AlexGyver/GRIx4_by_KARMAN/Photo/Model_bot.png

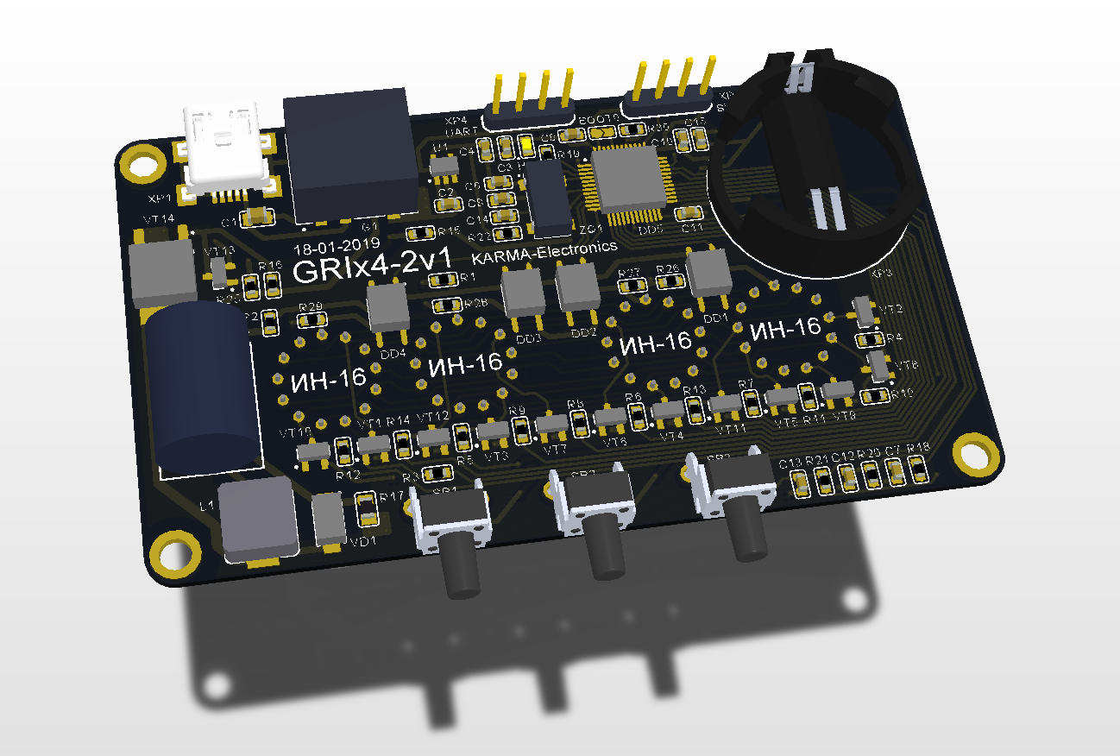
Photo/Model_bot.png
