AlexGyver/GRIx4_by_KARMAN/Photo/PCB2.jpg

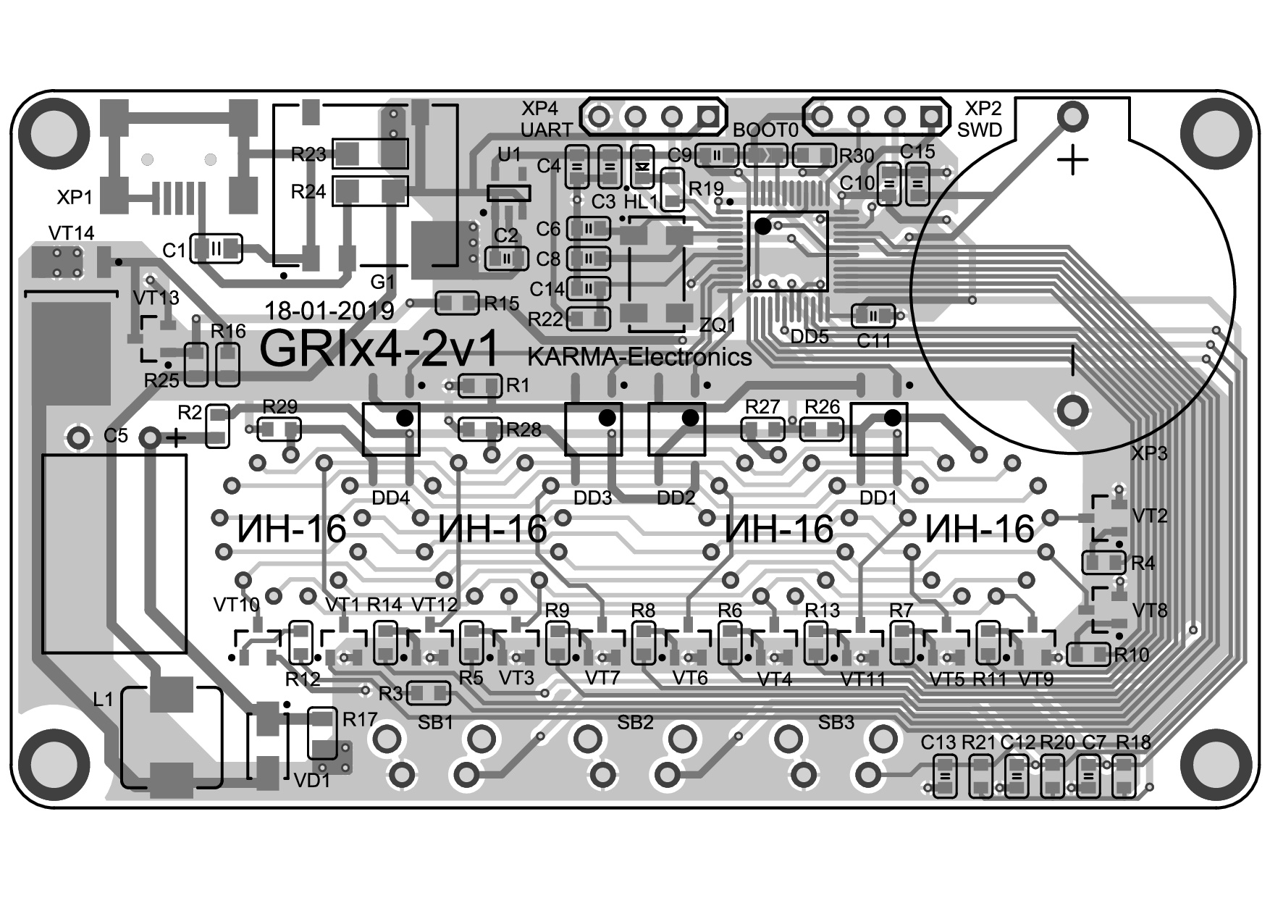
Photo/PCB2.jpg
