AlexGyver/GRIx4_by_KARMAN/Photo/PCB3.jpg

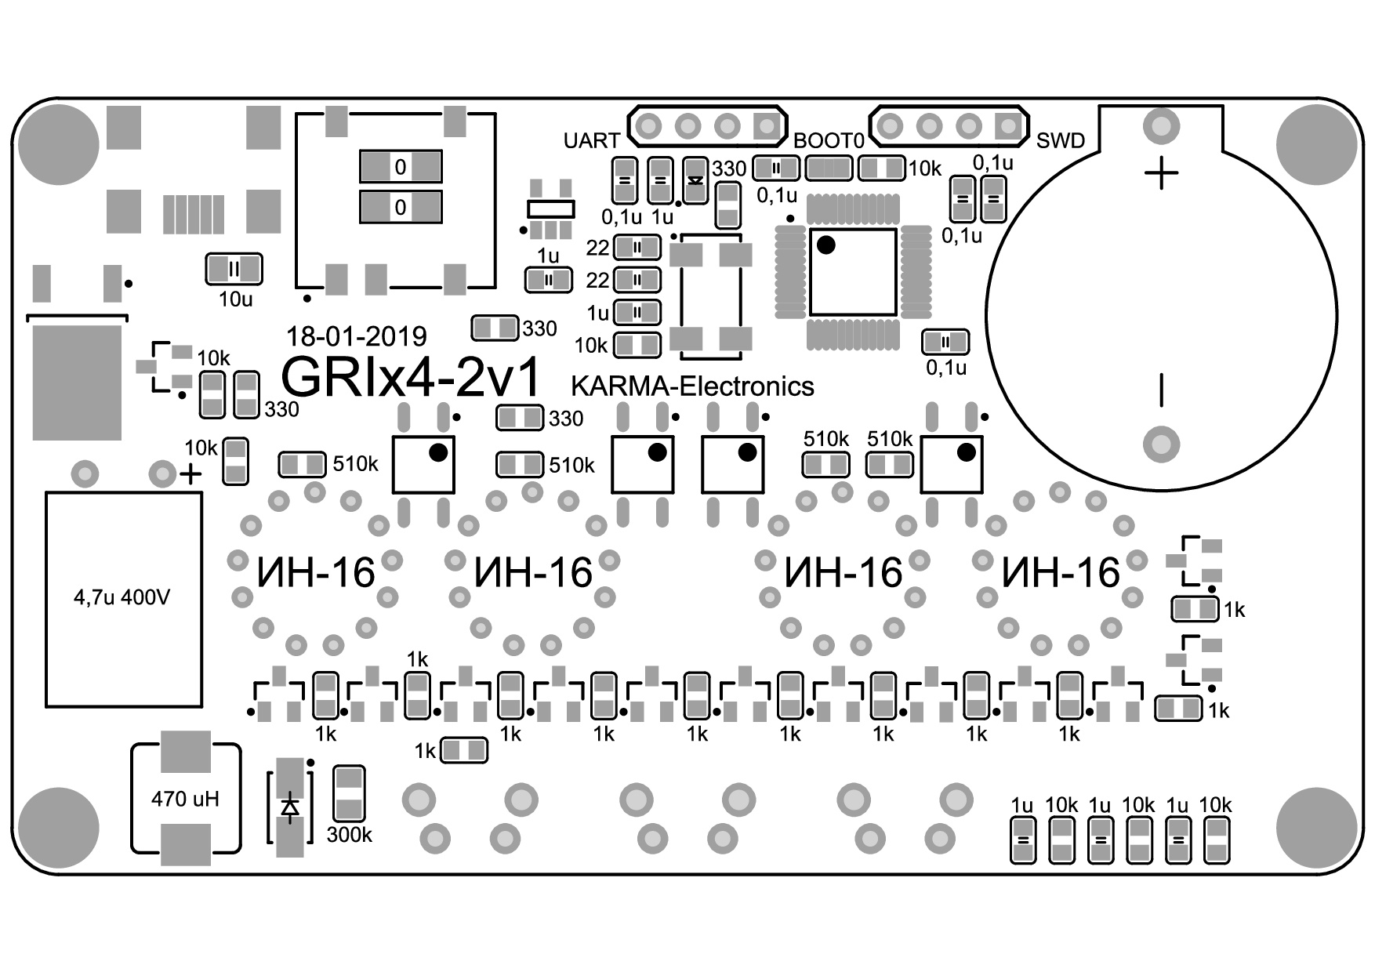
Photo/PCB3.jpg
