AlexGyver/GRIx4_by_KARMAN/Photo/Photo1.jpg

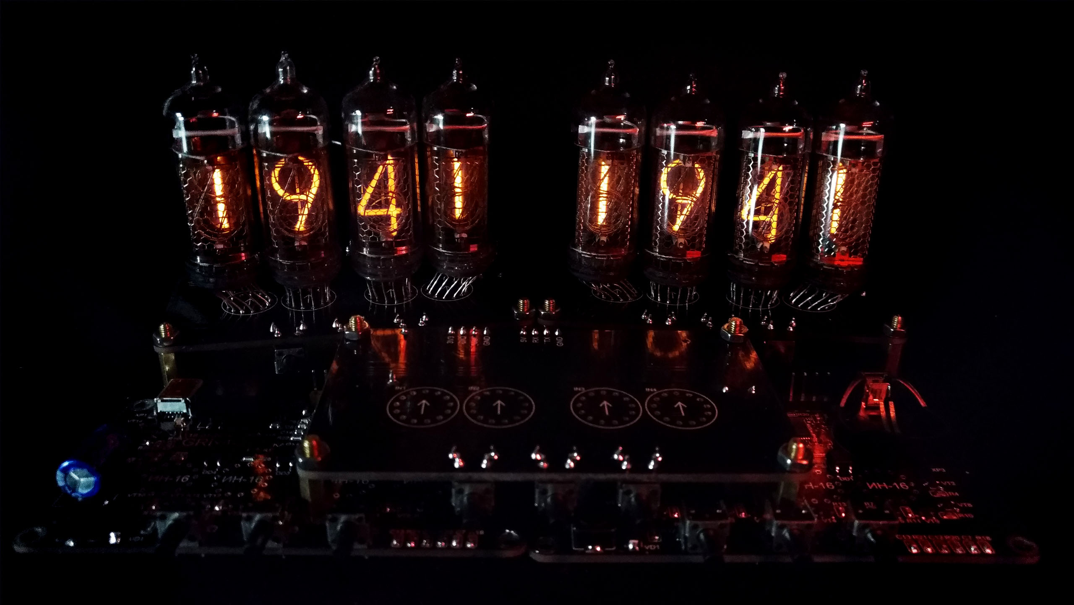
Photo/Photo1.jpg
