AlexGyver/GRIx4_by_KARMAN/Photo/Photo2.jpg

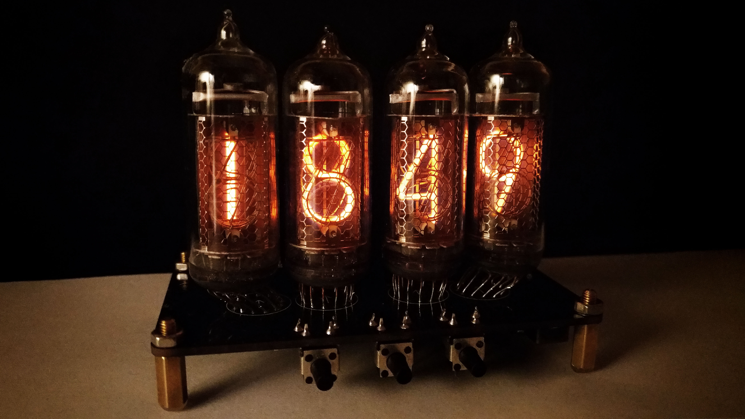
Photo/Photo2.jpg
