AlexGyver/GRIx4_by_KARMAN/Photo/Photo3.jpg

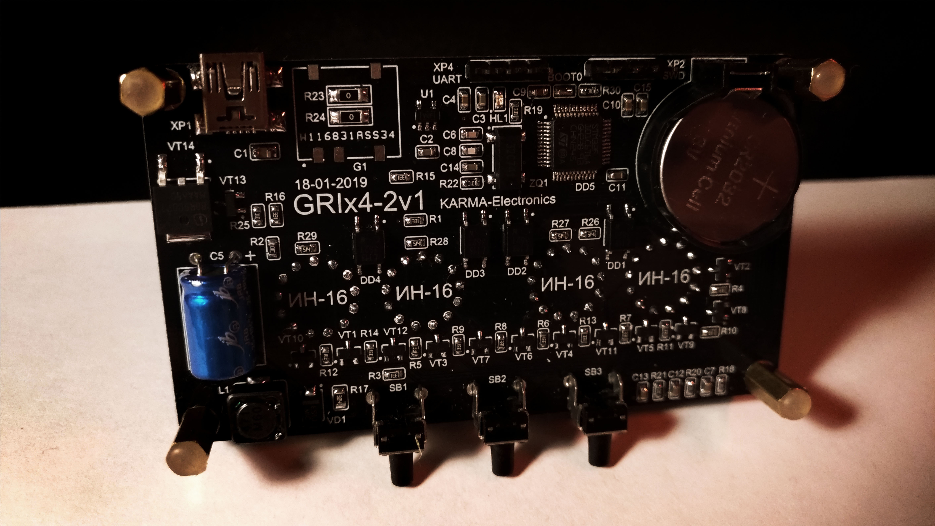
Photo/Photo3.jpg
