AlexGyver/GRIx4_by_KARMAN/(list of files, drawings)

Other design files:
Public/Проект [altium]/GRIx4.PrjPcb
Public/Проект [altium]/GRIx4.SchDoc
