AlexGyver/GRIx4_by_KARMAN/Public/Прошивка [sw4stm32]/Project/GRI.ioc

Mcu.UserName=STM32F101C6Tx
PA0-WKUP.Signal=GPIO_Output
PA1.Signal=GPIO_Output
PA11.Signal=GPIO_Output
PA12.Signal=GPIO_Output
PA13.Signal=SYS_JTMS-SWDIO
PA14.Signal=SYS_JTCK-SWCLK
PA2.Signal=GPIO_Output
PA3.Signal=GPIO_Output
PA4.Signal=GPIO_Output
PA5.Signal=GPIO_Output
PA6.Signal=GPIO_Output
PA7.Signal=GPIO_Input
PA8.Signal=GPIO_Output
PB0.Signal=GPIO_Input
PB1.Signal=GPIO_Input
PB10.Signal=GPIO_Output
PB11.Signal=GPIO_Output
PB12.Signal=GPIO_Output
PB13.Signal=GPIO_Output
PB14.Signal=GPIO_Output
PB15.Signal=GPIO_Output
PB4.Signal=S_TIM3_CH1
PC13-TAMPER-RTC.Signal=GPIO_Output
PC14-OSC32_IN.Signal=RCC_OSC32_IN
PC15-OSC32_OUT.Signal=RCC_OSC32_OUT
