AlexGyver/GRIx4_by_KARMAN/Public/Прошивка [sw4stm32]/Project/Drivers/GRI/GRI.h

#include "stm32f1xx_hal.h"

// Определение деректив переключения катодов
#define C1_set		HAL_GPIO_WritePin(GPIOA, GPIO_PIN_11, GPIO_PIN_SET)
#define C1_res		HAL_GPIO_WritePin(GPIOA, GPIO_PIN_11, GPIO_PIN_RESET)
#define C2_set		HAL_GPIO_WritePin(GPIOB, GPIO_PIN_14, GPIO_PIN_SET)
#define C2_res		HAL_GPIO_WritePin(GPIOB, GPIO_PIN_14, GPIO_PIN_RESET)
#define C3_set		HAL_GPIO_WritePin(GPIOA, GPIO_PIN_4, GPIO_PIN_SET)
#define C3_res		HAL_GPIO_WritePin(GPIOA, GPIO_PIN_4, GPIO_PIN_RESET)
#define C4_set		HAL_GPIO_WritePin(GPIOA, GPIO_PIN_5, GPIO_PIN_SET)
#define C4_res		HAL_GPIO_WritePin(GPIOA, GPIO_PIN_5, GPIO_PIN_RESET)
#define C5_set		HAL_GPIO_WritePin(GPIOB, GPIO_PIN_15, GPIO_PIN_SET)
#define C5_res		HAL_GPIO_WritePin(GPIOB, GPIO_PIN_15, GPIO_PIN_RESET)
#define C6_set		HAL_GPIO_WritePin(GPIOA, GPIO_PIN_6, GPIO_PIN_SET)
#define C6_res		HAL_GPIO_WritePin(GPIOA, GPIO_PIN_6, GPIO_PIN_RESET)
#define C7_set		HAL_GPIO_WritePin(GPIOB, GPIO_PIN_12, GPIO_PIN_SET)
#define C7_res		HAL_GPIO_WritePin(GPIOB, GPIO_PIN_12, GPIO_PIN_RESET)
#define C8_set		HAL_GPIO_WritePin(GPIOA, GPIO_PIN_12, GPIO_PIN_SET)
#define C8_res		HAL_GPIO_WritePin(GPIOA, GPIO_PIN_12, GPIO_PIN_RESET)
#define C9_set		HAL_GPIO_WritePin(GPIOB, GPIO_PIN_10, GPIO_PIN_SET)
#define C9_res		HAL_GPIO_WritePin(GPIOB, GPIO_PIN_10, GPIO_PIN_RESET)
#define C10_set	HAL_GPIO_WritePin(GPIOB, GPIO_PIN_11, GPIO_PIN_SET)
#define C10_res	HAL_GPIO_WritePin(GPIOB, GPIO_PIN_11, GPIO_PIN_RESET)
#define C11_set   HAL_GPIO_WritePin(GPIOB, GPIO_PIN_13, GPIO_PIN_SET)
#define C11_res	HAL_GPIO_WritePin(GPIOB, GPIO_PIN_13, GPIO_PIN_RESET)
#define C12_set   HAL_GPIO_WritePin(GPIOA, GPIO_PIN_8, GPIO_PIN_SET)
#define C12_res	HAL_GPIO_WritePin(GPIOA, GPIO_PIN_8, GPIO_PIN_RESET)

// Определение деректив переключения анодов
#define A1_set		HAL_GPIO_WritePin(GPIOA, GPIO_PIN_3, GPIO_PIN_SET)
#define A1_res		HAL_GPIO_WritePin(GPIOA, GPIO_PIN_3, GPIO_PIN_RESET)
#define A2_set		HAL_GPIO_WritePin(GPIOA, GPIO_PIN_2, GPIO_PIN_SET)
#define A2_res		HAL_GPIO_WritePin(GPIOA, GPIO_PIN_2, GPIO_PIN_RESET)
#define A3_set		HAL_GPIO_WritePin(GPIOA, GPIO_PIN_1, GPIO_PIN_SET)
#define A3_res		HAL_GPIO_WritePin(GPIOA, GPIO_PIN_1, GPIO_PIN_RESET)
#define A4_set		HAL_GPIO_WritePin(GPIOA, GPIO_PIN_0, GPIO_PIN_SET)
#define A4_res		HAL_GPIO_WritePin(GPIOA, GPIO_PIN_0, GPIO_PIN_RESET)

// Определение деректив чтения состояния кнопок
#define BUT_L		HAL_GPIO_ReadPin(GPIOB, GPIO_PIN_0)
#define BUT_M		HAL_GPIO_ReadPin(GPIOA, GPIO_PIN_7)
#define BUT_R		HAL_GPIO_ReadPin(GPIOB, GPIO_PIN_1)


void ResAll(void);															// Одновременное отключение всех катодов
void SetAll(void);															// Одновременное включение всех катодов
void OPset(uint8_t n);														// Включение указанного анода
void OPres(uint8_t n);														// Отключение указанного анода
void TRset(uint8_t n);														// Включение указанного катода
void HVset(uint32_t V1, uint32_t V2);							// Установка режима генерации ШИМ
void wait(uint32_t cnt);													// Функция задержки
