AlexGyver/GRIx4_by_KARMAN/Soft/Flash Loader Demonstrator/Sources/STBLLIB/StdAfx.h

#if !defined(AFX_STDAFX_H__5756AFC7_1A09_4C0E_B6E8_BA86A975A687__INCLUDED_)
#define AFX_STDAFX_H__5756AFC7_1A09_4C0E_B6E8_BA86A975A687__INCLUDED_

#define _CRT_SECURE_NO_WARNINGS  

#if _MSC_VER > 1000
#pragma once
#endif // _MSC_VER > 1000


// Insert your headers here
#define WIN32_LEAN_AND_MEAN		// Exclude rarely-used stuff from Windows headers


#include <windows.h>

//#include "../Files/Files.h"

// TODO: reference additional headers your program requires here

//{{AFX_INSERT_LOCATION}}
// Microsoft Visual C++ will insert additional declarations immediately before the previous line.

#endif // !defined(AFX_STDAFX_H__5756AFC7_1A09_4C0E_B6E8_BA86A975A687__INCLUDED_)
