AlexGyver/GRIx4_by_KARMAN/(notices)

Notices in the files:
Public/Прошивка [sw4stm32]/Project/Src/main.c:
COPYRIGHT(c) 2019 STMicroelectronics
(C) COPYRIGHT STMicroelectronics *****END OF FILE
